loranga/Loranga-Gateway/Hardware/README.md

# Hardware

Loranga is a fully open-source product. So you can ask for the gerber files if you want to make or modify your own Loranga

Below you can find an example of the gerber files.

You can find the Bill of Materials for Loranga under the BOM folder

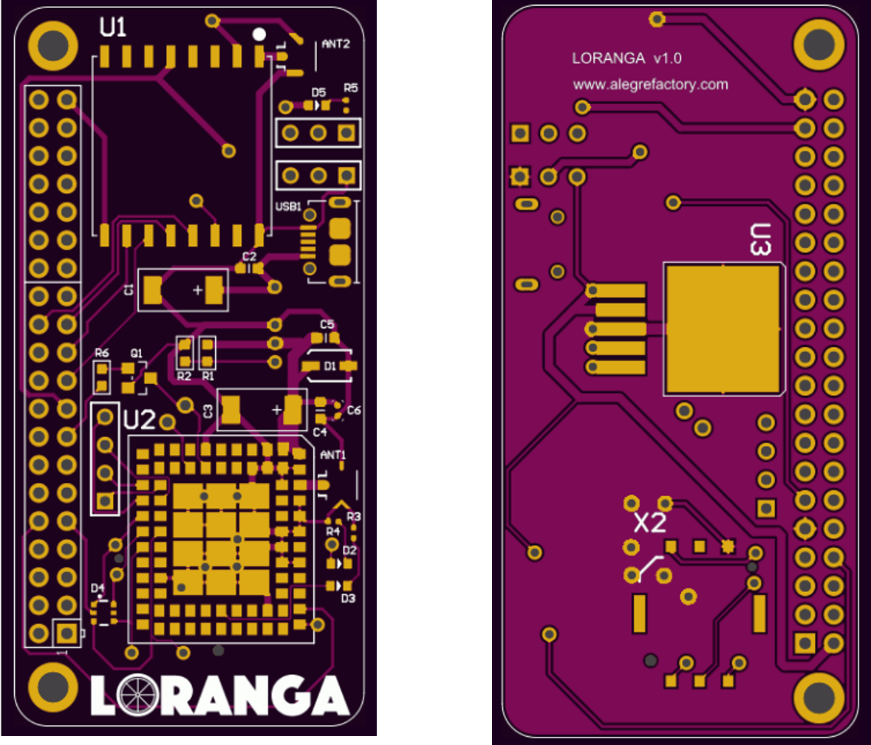
[picture p2: Docs/Photos/loranga_pcb.png]
Image of gerber files
