loranga/Loranga-Gateway/Software/README.md

# Loranga
The IoT gateway for Raspberry pi
