loranga/Loranga-Gateway/Docs/Photos/nano_lora_gsm.png

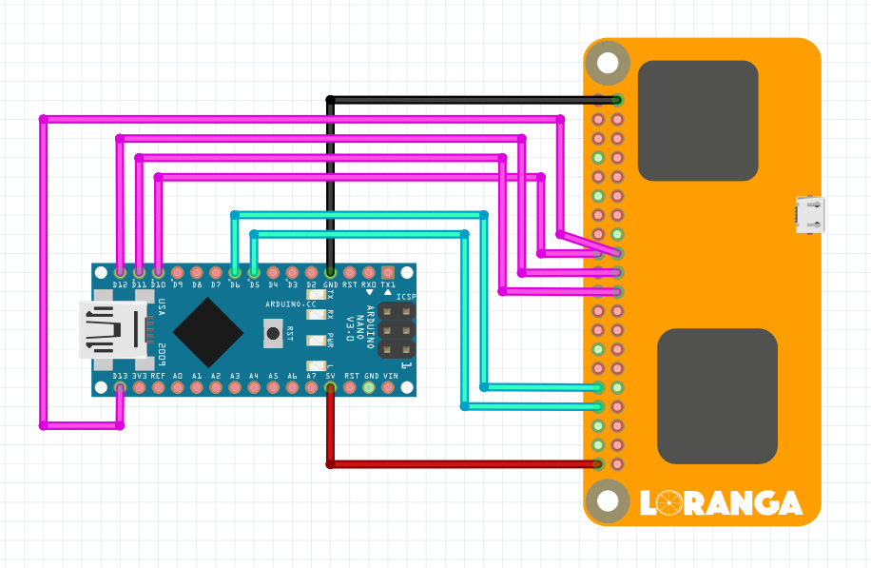
Docs/Photos/nano_lora_gsm.png
