loranga/Loranga-Gateway/(commit log)

2017-09-14 arduino examples 1
2017-09-14 add photo arduino
2017-09-25 add Arduino examples
2017-09-25 arduino codes
2018-05-10 Test files for loranga board
